g7ltt/K6BEZ-Antenna-Analyser/README.md

# K6BEZ Antenna Analyser

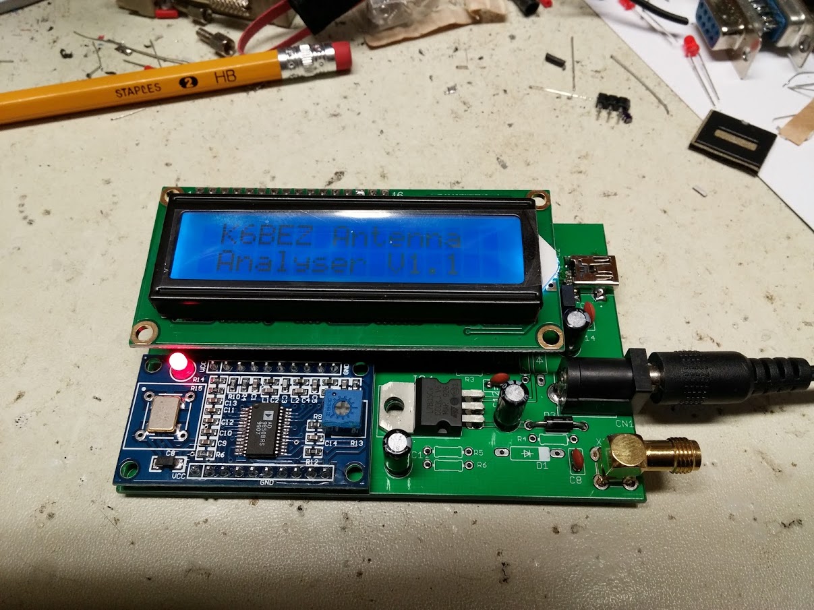
[picture p1: IMG_20150107_172233.jpg]
finished board
