g7ltt/K6BEZ-Antenna-Analyser/K6BEZ_Arduino_Antenna Analyser-corrected.pdf

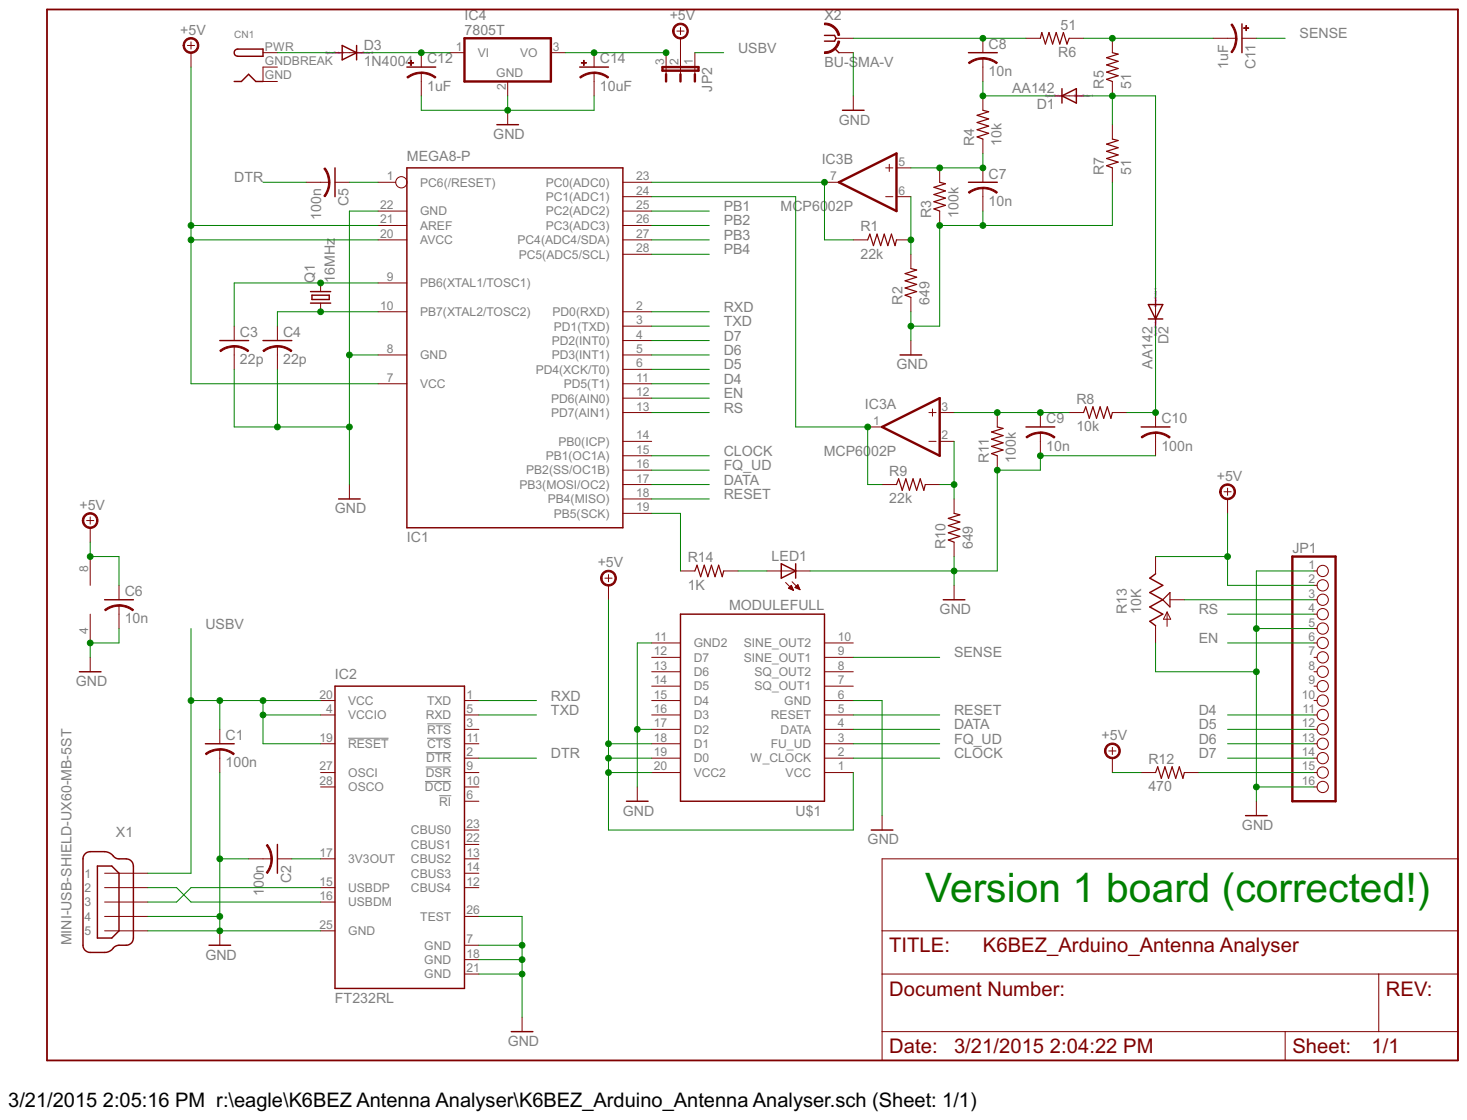
[picture p2: page 1]

MINI-USB-SHIELD-UX60-MB-5ST GND

3/21/2015 2:05:16 PM r:\eagle\K6BEZ Antenna Analyser\K6BEZ_Arduino_Antenna Analyser.sch (Sheet: 1/1)
