g7ltt/K6BEZ-Antenna-Analyser/K6BEZ_Arduino_Antenna Analyser.pdf

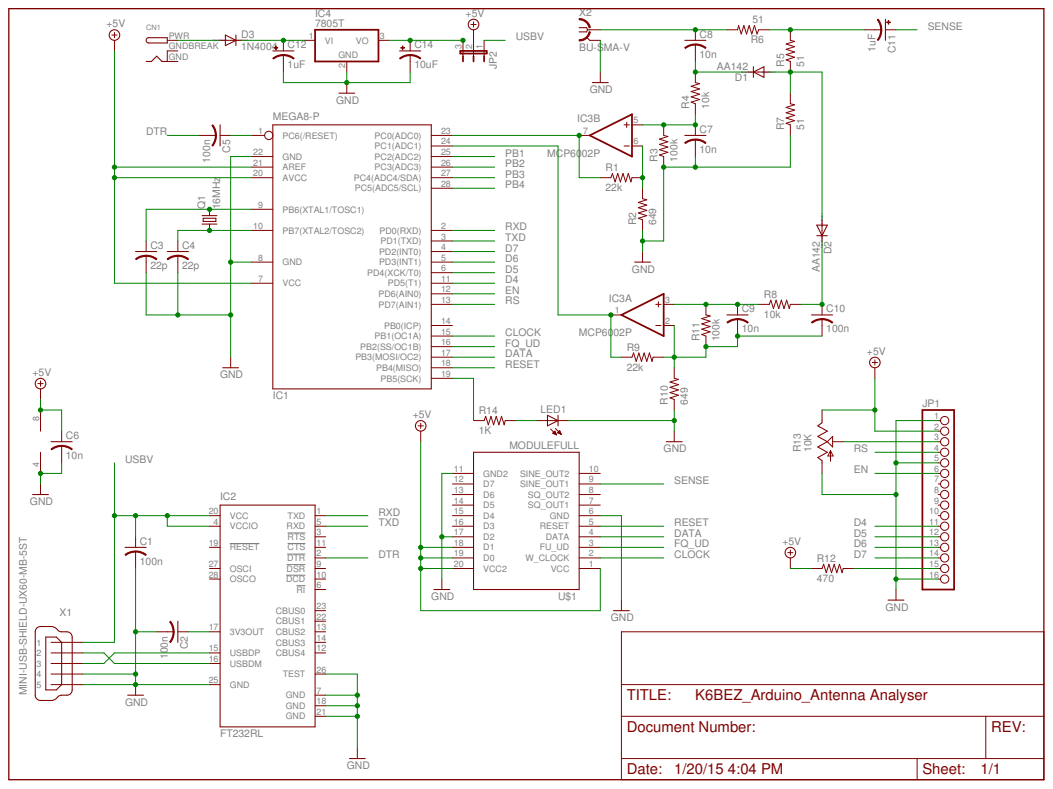
[picture p3: page 1]

MINI-USB-SHIELD-UX60-MB-5ST GND
