g7ltt/K6BEZ-Antenna-Analyser/K6BEZ_Arduino_Antenna Analyser.brd

## EAGLE design K6BEZ_Arduino_Antenna Analyser.brd (2021-08-31)

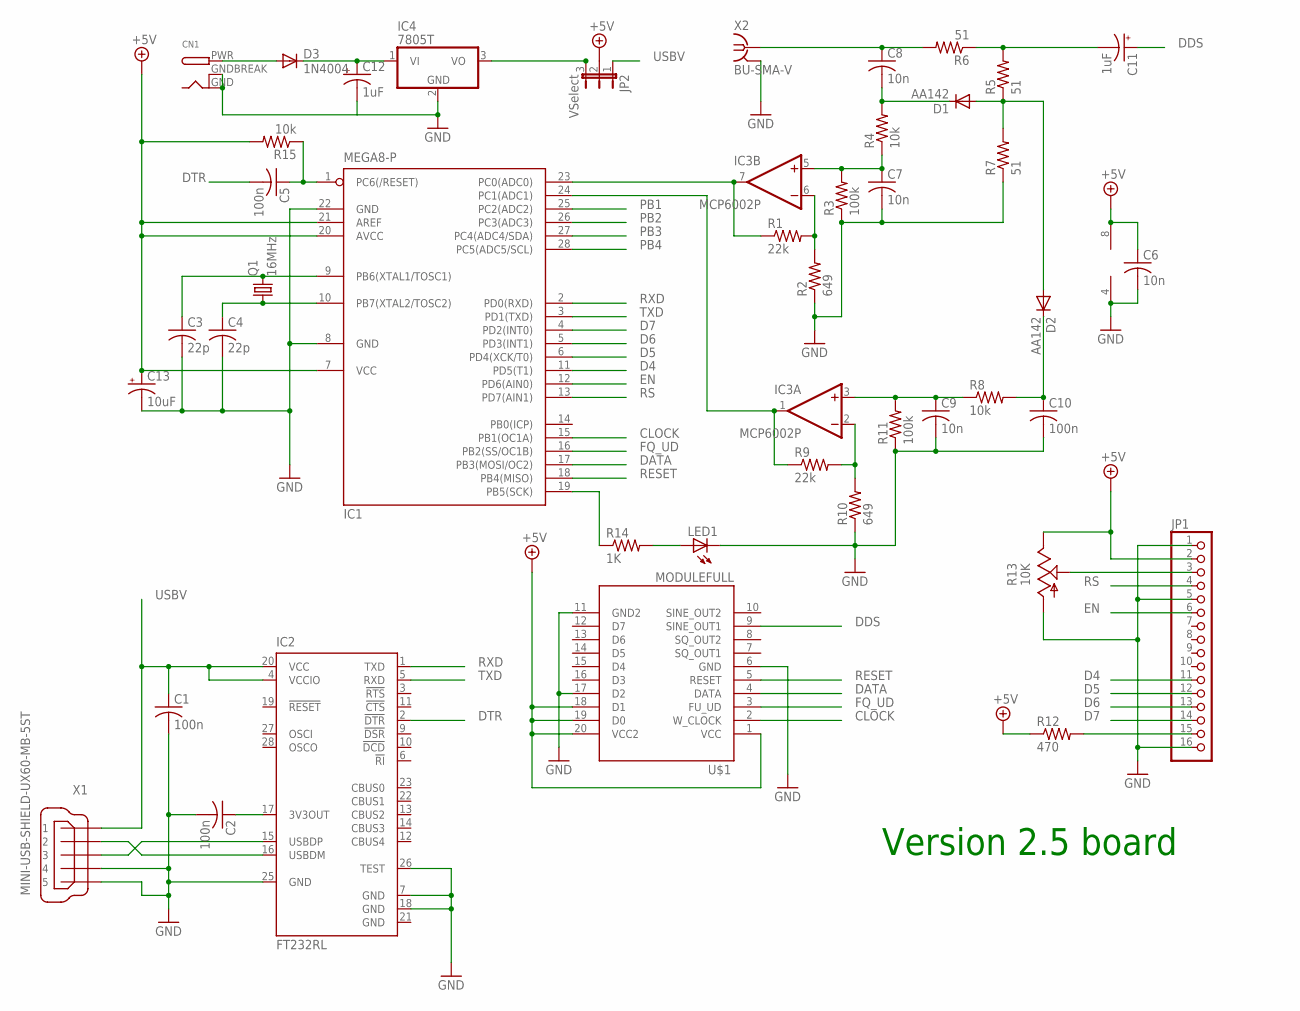
[picture p4: schematic K6BEZ_Arduino_Antenna Analyser.sch]

Parts:
C1, C2, C5, C10: 100n; C025-025X050
C3, C4: 22p; C025-025X050
C6, C7, C8, C9: 10n; C025-025X050
C11, C12: 1uF; E2,5-5
C13: 10uF; E2,5-5
CN1: DCBARRELPTH; DCJACK_2MM_PTH
D1, D2: AA142; DO07
D3: 1N4004; DO41-10
IC1: MEGA8-P; DIL28-3
IC2: FT232RL; SSOP28
IC3: MCP6002P; DIL08
IC4: 7805T; TO220H
JP1: PINHD-1X16; 1X16
JP2: VSelect; JP2
LED1: LED3MM
Q1: 16MHz; HC49/S
R1, R9: 22k; 0204/7
R2, R10: 649; 0204/7
R3, R11: 100k; 0204/7
R4, R8, R15: 10k; 0204/7
R5, R6, R7: 51; 0204/7
R12: 470; 0204/7
R13: 10K; CA6V
R14: 1K; 0204/7
U$1: MODULEFULL; MODULE
X1: MINI-USB-SHIELD-UX60-MB-5ST; UX60-MB-5ST
X2: BU-SMA-V

Connections:
+5V: C6.1, C13.+, IC1.7 (VCC), IC1.20 (AVCC), IC1.21 (AREF), IC3.8 (V+), JP1.2, JP2.2, R12.1, R13.E, R15.2, U$1.1 (VCC), U$1.18 (D1), U$1.19 (D0), U$1.20 (VCC2)
CLOCK: IC1.15 (PB1(OC1A)), U$1.2 (W_CLOCK)
D4: IC1.11 (PD5(T1)), JP1.11
D5: IC1.6 (PD4(XCK/T0)), JP1.12
D6: IC1.5 (PD3(INT1)), JP1.13
D7: IC1.4 (PD2(INT0)), JP1.14
DATA: IC1.17 (PB3(MOSI/OC2)), U$1.4 (DATA)
DDS: C11.+, U$1.9 (SINE_OUT1)
DTR: C5.2, IC2.2 (!DTR)
EN: IC1.12 (PD6(AIN0)), JP1.6
FQ_UD: IC1.16 (PB2(SS/OC1B)), U$1.3 (FU_UD)
GND: C1.2, C2.2, C3.2, C4.2, C6.2, C7.2, C9.2, C10.2, C12.-, C13.-, CN1.GND, CN1.GNDBREAK, IC1.8 (GND), IC1.22 (GND), IC2.7 (GND), IC2.18 (GND), IC2.21 (GND), IC2.25 (GND), IC2.26 (TEST), IC3.4 (V-), IC4.2 (GND), JP1.1, JP1.5, JP1.16, LED1.K (C), R2.1, R3.1, R7.1, R10.1, R11.1, R13.A, U$1.6 (GND), U$1.11 (GND2), U$1.17 (D2), X1.4, X1.5, X2.2, X2.3 (2), X2.4 (2), X2.5 (2)
unnamed: C3.1, IC1.9 (PB6(XTAL1/TOSC1)), Q1.2
unnamed: IC2.16 (USBDM), X1.2
unnamed: IC2.15 (USBDP), X1.3
unnamed: C4.1, IC1.10 (PB7(XTAL2/TOSC2)), Q1.1
unnamed: C2.1, IC2.17 (3V3OUT)
unnamed: JP1.15, R12.2
unnamed: IC1.23 (PC0(ADC0)), IC3.7 (OUT), R1.1
unnamed: C5.1, IC1.1 (PC6(/RESET)), R15.1
unnamed: IC3.6 (-IN), R1.2, R2.2
unnamed: C7.1, IC3.5 (+IN), R3.2, R4.1
unnamed: JP1.3, R13.S
unnamed: C8.2, D1.C, R4.2
unnamed: C8.1, R6.2, X2.1
unnamed: C11.-, R5.2, R6.1
unnamed: D1.A, D2.A, R5.1, R7.2
unnamed: LED1.A, R14.2
unnamed: C9.1, IC3.3 (+IN), R8.1, R11.2
unnamed: IC1.24 (PC1(ADC1)), IC3.1 (OUT), R9.1
unnamed: IC1.19 (PB5(SCK)), R14.1
unnamed: C10.1, D2.C, R8.2
unnamed: C12.+, D3.C, IC4.1 (VI)
unnamed: CN1.PWR, D3.A
unnamed: IC4.3 (VO), JP2.3
unnamed: IC3.2 (-IN), R9.2, R10.2
PB1: IC1.25 (PC2(ADC2))
PB2: IC1.26 (PC3(ADC3))
PB3: IC1.27 (PC4(ADC4/SDA))
PB4: IC1.28 (PC5(ADC5/SCL))
RESET: IC1.18 (PB4(MISO)), U$1.5 (RESET)
RS: IC1.13 (PD7(AIN1)), JP1.4
RXD: IC1.2 (PD0(RXD)), IC2.1 (TXD)
TXD: IC1.3 (PD1(TXD)), IC2.5 (RXD)
USBV: C1.1, IC2.4 (VCCIO), IC2.20 (VCC), JP2.1, X1.1

Notes on the sheet:
Version 2.5 board

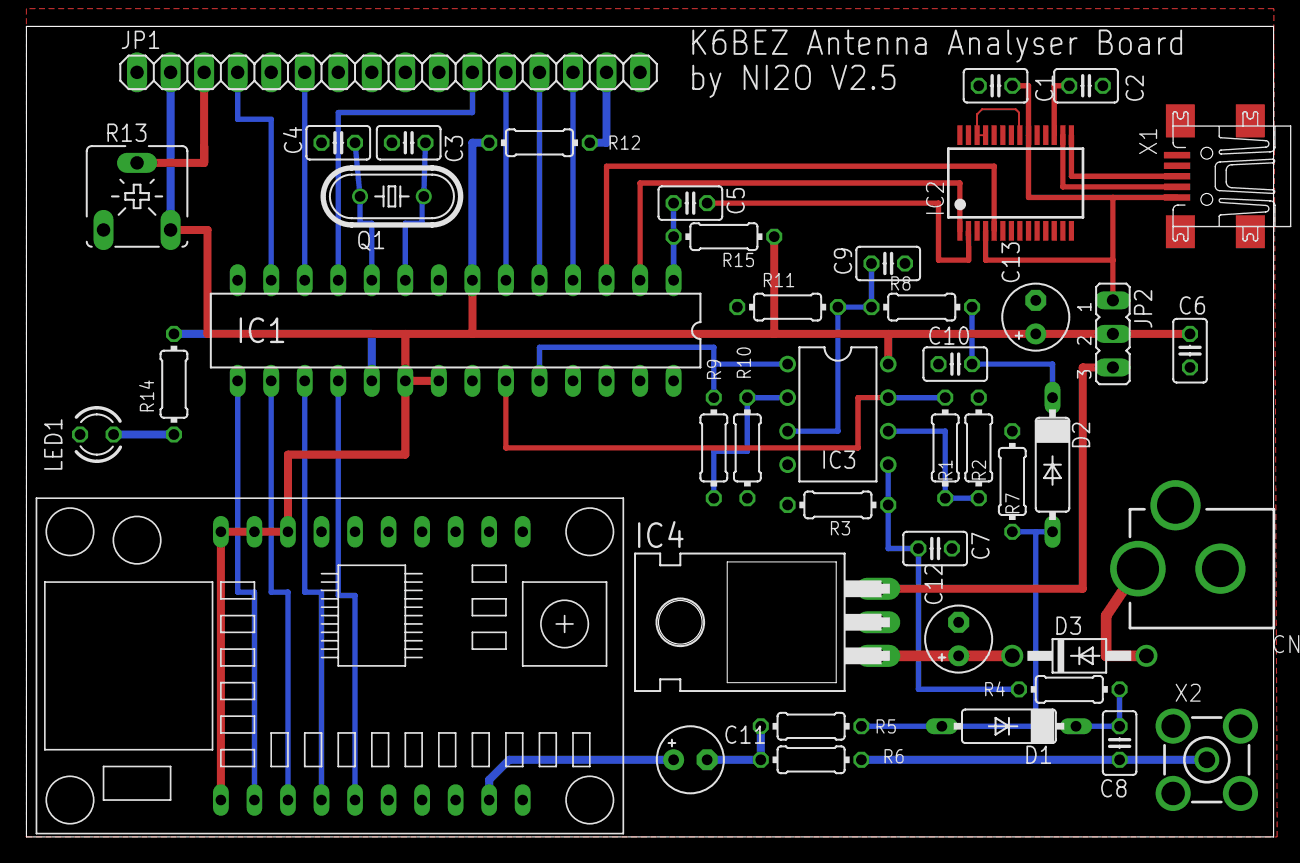
[picture p5: board K6BEZ_Arduino_Antenna Analyser.brd from above]

Board: 2 copper layers, 94.5 x 61.4 mm, 43 parts (0 on the bottom side), 41 nets.
